chickey/keepalive-prog/docs/og-image.png

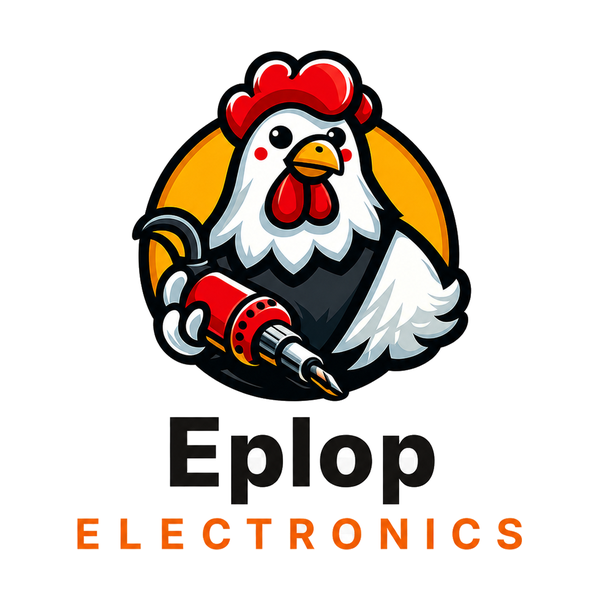
docs/og-image.png
