chickey/keepalive-prog/firmware/src/power.h

#ifndef POWER_H
#define POWER_H
#include <stdint.h>
void     power_init(void);
void     power_calibrate(void);    // measure the AWU tick (needs SysTick running)
uint32_t power_awu_tick_us(void);
uint32_t power_min_sleep_ms(void);
uint32_t power_deep_sleep(uint32_t ms, uint8_t *by_button);
#endif
