chickey/keepalive-prog/(commit log)

2026-10-15 Add a Firmware button to the config page header (#2)
2026-10-29 Wait 60 s for a host (macOS accessory prompt) and let presets be disabled (fw 1.0.1) (#3)
    * Wait up to 60 s for a host so macOS can ask to allow the accessory
    On Apple-silicon laptops macOS asks the user to allow a new USB accessory
    before enumerating it. The firmware gave a host 1.5 s, then decided it was
    on a power bank and dropped off the bus, so the prompt vanished.
    Detection is now non-blocking: the board attaches, runs the active preset
    from power-up, and switches to config mode (pulsing paused, LED on) if a
    host enumerates it within 60 s. Deep sleep waits until it has given up on
    a host. Firmware 1.0.1, rebuilt and published to the web flasher.
    * Let presets be disabled so the butt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
2026-10-29 Flasher: open the device list first and install straight away (#4)
    The WCH bootloader starts the old firmware again about 5 s after it
    enumerates if nothing talks to it, so the device vanished from Chrome's
    list before it could be picked. Now Install firmware opens the list
    first (or reuses an already-permitted bootloader), the user plugs in
    with BOOT held, and flashing starts as soon as it connects. A locked
    chip waits for the user, with the bootloader pinged every second; ISP
    transfers are queued so pings can't interleave. The steps mention that
    Chrome lists it as a QinHeng Electronics device, and the udev rule now
    covers 1a86:55e0 as well as 4348:55e0.
2026-10-29 Fix frozen clock and garbled serial output (fw 1.0.2) (#5)
    Found on the first real board:
    - The 1 ms clock froze. SysTick did ms++ and CMP += 1 ms in its
    interrupt; once a tick was serviced late the compare fell behind the
    64-bit counter and the interrupt stopped. A pulse then never ended and
    the LED stayed on, and on a power bank pulses never started. Time is
    now read from the counter; the interrupt only wakes the main loop.
    - About 1 serial line in 20 reached the host with a 4-byte word zeroed
    (the cause of the NaN on the config page). It stopped when the main
    loop no longer runs WFI while on USB. SRAM is also kept clocked in
    sleep, and USB IN packets are sent without the ex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
    [board.h, keepalive.c, usbio.c]
2026-10-29 LED modes, quick-tap button and debounce (fw 1.0.3) (#6)
    - Light on a power bank is now a setting (OPTS led=0|1|2, saved with
    SAVE): off, a short flash as each pulse starts, or the 10 s preset
    blink (default, as before). Shown as three options on the config page.
    - With only one preset enabled, blinks are a single blink instead of the
    preset number, and a press doesn't restart the pulse timing.
    - A tap released within 0.5 s steps the preset; holding 0.5 s shows it
    (was 1.5 s, where a slow tap could change the preset by mistake).
    - Button debounce 50 ms plus a 200 ms lockout after release: one board
    sometimes saw a single press as two.
    - With nothing due (no blink, 0 mA preset) deep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
    [app.h, board.h, keepalive.c, proto.c, store.c, test_host.c, ui.c, ui.h]
2026-10-29 Correct standby timing and add DIAG (fw 1.0.4) (#7)
    Measured on the board: an AWU window of W ticks gives W + 1 ticks
    (8 -> 196.6 ms, 4 -> 109.2 ms; 21.84 ms per tick awake). Deep sleep now
    programs ticks - 1, so each sleep lasts what it is counted as.
    - power_calibrate() measures the AWU tick against SysTick at power-up
    (21845 us on the test board) instead of relying on a constant.
    - Sleep time is counted from just before sleeping rather than from the
    top of the loop, to lose less time per wake.
    - New DIAG command reports the measured tick (awu_us).
    Stopwatch on a power bank with 1.0.4-test3 (preset 1 s on / 20 s off):
    laps 20.4-21.6 s, mean 21.1 s.
    [app.h, board.h, keepalive.c, power.c, power.h, proto.c, test_host.c]
2026-10-29 Flasher: update a running Keep Alive, install on click (#8)
    - Restart into update mode: the flash page finds the running Keep Alive
    over Web Serial (remembered after the first time), opens the WebUSB
    device list while the click still counts, sends BOOT, and connects to
    the bootloader when it appears. The BOOT button is only needed for a
    first install or broken firmware (now under a collapsible section).
    - Connecting no longer installs straight away: the page shows the chip
    and the firmware version, pings the bootloader once a second so it
    stays in update mode, and installs only on Install firmware.
    - On load, a remembered Keep Alive port is opened briefly to show which
    firmware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
2026-10-29 Hard pulse limits and clearer firmware versions (fw 1.0.5) (#9)
    Firmware (enforced on the device):
    - A pulse lasts 10 ms to 30 s (was 10 min).
    - Off time at least as long as on time: 50% duty at most, so no
    continuous load.
    - A whole cycle (on + off) is at most 1 hour.
    - SET checks the resulting preset as a whole and refuses anything
    outside the limits; LIMITS adds period_max and duty_max.
    - Presets saved by older firmware are clamped into the limits at
    power-up instead of being discarded.
    Config page: continuous-load option hidden on 1.0.5+, limits explained
    above the presets, and validation messages for each rule.
    Flash page: the Firmware card shows 'On your Keep Alive' and 'Availa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
2026-10-30 Chart: time labels and freeze when the trial stops (#10)
    - X axis labelled -30 s, -20 s, -10 s and now, with faint gridlines
    every 10 s (suggested by a tester).
    - Stop trial freezes the chart where it was; the right-hand label reads
    'stopped' and the legend 'paused'. Start trial resumes scrolling. A
    test pulse while stopped plays live, then the chart freezes again just
    after it, with the pulse in view.
    - Chart 16 px taller to make room for the labels.
